Ira-Doshi/Design-and-Development-of-a-Self-Righting-Airdropped-Floating-Pod-for-Flood-Relief/Screenshot 2026-02-21 163044.png

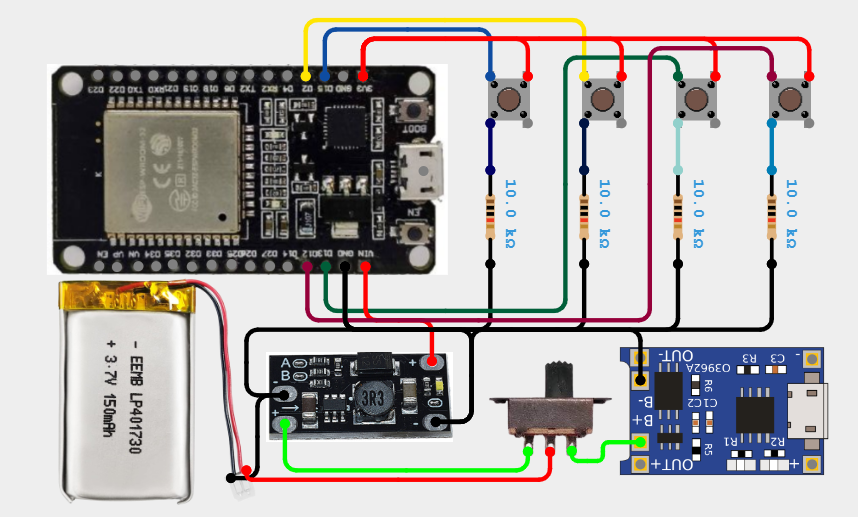
Screenshot 2026-02-21 163044.png
