Ira-Doshi/Design-and-Development-of-a-Self-Righting-Airdropped-Floating-Pod-for-Flood-Relief/README.md

# Design-and-Development-of-a-Self-Righting-Airdropped-Floating-Pod-for-Flood-Relief

As global warming and rapid urbanization continues, abnormal weather phenomena such as localized downpours and flooding have become more and more frequent and intense [1,2]. A great number of metropolitan cities have suffered from flood hazards, which incurred irreducible and severe damage to local people and urban infrastructures. During floods there are few major issues and challenges such as flood preparations, lack of rescuers, lack of awareness, communication difficulty, lack of assets for rescue, transportation issues, the absence of food supply, and other constraints. On the other hand, the challenges are lack of provisions, redevelopment, the social and economic situation, and trauma. The focus of our study is to tackle the key pressing issue of transportation. A major issue for transport is that there is no helicopter landing pad to send food in most flood affected areas. The only suitable option remaining is to throw the food from the air. The poor working condition of some of the available boats does not allow them to continue their rescue efforts. I think these needs to be emphasized and there should be a specific boat for the rescue operation. This is very important because the boat and hovercraft are the needed transport when the road is closed.To address these transportation constraints, our project proposes the development of a remote controlled Self-righting Airdrop floating pod prototype designed specifically for emergency supply delivery in flooded environments. In contrast to conventional boats or helicopters, this small, remotely operated vehicle is capable of traversing narrow waterways filled with debris without demanding a landing zone, allowing for extreme flexibility in urban flood situations. Together with these features, the water drone aims to provide a reliable, low-cost, and rapidly accessible resource. Successful deployment of this water drone could lead to significant reductions in time to deliver aid, improve the work of disaster-response teams, and ultimately save lives in serious flood events.
